tidiazb/Proyecto_03_Batalla_Naval/Planteamiento_Diseno/datapath/N2_core.png

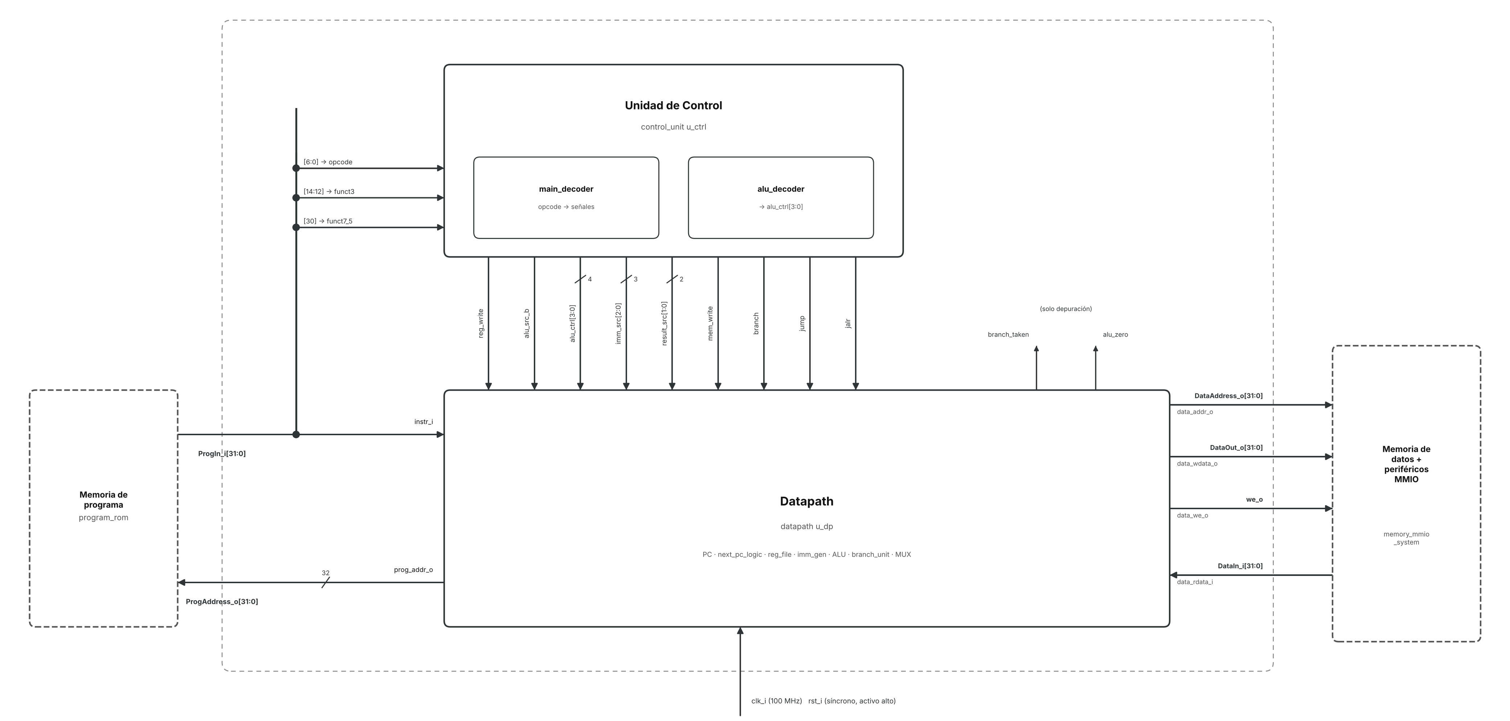
Planteamiento_Diseno/datapath/N2_core.png
