tidiazb/Proyecto_03_Batalla_Naval/Nucleo_VGA/modulos_nucleo_vga/font_rom.sv

`timescale 1ns / 1ps

// ============================================================
// Módulo: font_rom
// Descripción:
//   ROM combinacional con una fuente de 5x7 píxeles para los 64
//   caracteres ASCII imprimibles de 0x20 (espacio) a 0x5F ('_'),
//   que incluye mayúsculas, dígitos y signos de puntuación.
//
//   char_idx_i es el código ASCII menos 0x20 y row_i la fila del
//   carácter (0 = arriba, 6 = abajo). bits_o entrega los 5 píxeles
//   de esa fila; el bit 4 es el píxel de la izquierda. La fila 7
//   y cualquier combinación no listada devuelven 0.
//
//   Se sintetiza como lógica (LUTs); no consume BRAM.
//   Archivo generado a partir de la tabla de la fuente.
// ============================================================

module font_rom (
    input  logic [5:0] char_idx_i,
    input  logic [2:0] row_i,
    output logic [4:0] bits_o
);

    always_comb begin
        bits_o = 5'b00000;
        case ({char_idx_i, row_i})
            {6'd1, 3'd0}: bits_o = 5'b00100; // '!'
            {6'd1, 3'd1}: bits_o = 5'b00100; // '!'
            {6'd1, 3'd2}: bits_o = 5'b00100; // '!'
            {6'd1, 3'd3}: bits_o = 5'b00100; // '!'
            {6'd1, 3'd4}: bits_o = 5'b00100; // '!'
            {6'd1, 3'd6}: bits_o = 5'b00100; // '!'
            {6'd2, 3'd0}: bits_o = 5'b01010; // '"'
            {6'd2, 3'd1}: bits_o = 5'b01010; // '"'
            {6'd3, 3'd0}: bits_o = 5'b01010; // '#'
            {6'd3, 3'd1}: bits_o = 5'b01010; // '#'
            {6'd3, 3'd2}: bits_o = 5'b11111; // '#'
            {6'd3, 3'd3}: bits_o = 5'b01010; // '#'
            {6'd3, 3'd4}: bits_o = 5'b11111; // '#'
            {6'd3, 3'd5}: bits_o = 5'b01010; // '#'
            {6'd3, 3'd6}: bits_o = 5'b01010; // '#'
            {6'd4, 3'd0}: bits_o = 5'b00100; // '$'
            {6'd4, 3'd1}: bits_o = 5'b01111; // '$'
            {6'd4, 3'd2}: bits_o = 5'b10100; // '$'
            {6'd4, 3'd3}: bits_o = 5'b01110; // '$'
            {6'd4, 3'd4}: bits_o = 5'b00101; // '$'
            {6'd4, 3'd5}: bits_o = 5'b11110; // '$'
            {6'd4, 3'd6}: bits_o = 5'b00100; // '$'
            {6'd5, 3'd0}: bits_o = 5'b11000; // '%'
            {6'd5, 3'd1}: bits_o = 5'b11001; // '%'
            {6'd5, 3'd2}: bits_o = 5'b00010; // '%'
            {6'd5, 3'd3}: bits_o = 5'b00100; // '%'
            {6'd5, 3'd4}: bits_o = 5'b01000; // '%'
            {6'd5, 3'd5}: bits_o = 5'b10011; // '%'
            {6'd5, 3'd6}: bits_o = 5'b00011; // '%'
            {6'd6, 3'd0}: bits_o = 5'b01100; // '&'
            {6'd6, 3'd1}: bits_o = 5'b10010; // '&'
            {6'd6, 3'd2}: bits_o = 5'b10100; // '&'
            {6'd6, 3'd3}: bits_o = 5'b01000; // '&'
            {6'd6, 3'd4}: bits_o = 5'b10101; // '&'
            {6'd6, 3'd5}: bits_o = 5'b10010; // '&'
            {6'd6, 3'd6}: bits_o = 5'b01101; // '&'
            {6'd7, 3'd0}: bits_o = 5'b00100; // '''
            {6'd7, 3'd1}: bits_o = 5'b00100; // '''
            {6'd8, 3'd0}: bits_o = 5'b00010; // '('
            {6'd8, 3'd1}: bits_o = 5'b00100; // '('
            {6'd8, 3'd2}: bits_o = 5'b01000; // '('
            {6'd8, 3'd3}: bits_o = 5'b01000; // '('
            {6'd8, 3'd4}: bits_o = 5'b01000; // '('
            {6'd8, 3'd5}: bits_o = 5'b00100; // '('
            {6'd8, 3'd6}: bits_o = 5'b00010; // '('
            {6'd9, 3'd0}: bits_o = 5'b01000; // ')'
            {6'd9, 3'd1}: bits_o = 5'b00100; // ')'
            {6'd9, 3'd2}: bits_o = 5'b00010; // ')'
            {6'd9, 3'd3}: bits_o = 5'b00010; // ')'
            {6'd9, 3'd4}: bits_o = 5'b00010; // ')'
            {6'd9, 3'd5}: bits_o = 5'b00100; // ')'
            {6'd9, 3'd6}: bits_o = 5'b01000; // ')'
            {6'd10, 3'd1}: bits_o = 5'b00100; // '*'
            {6'd10, 3'd2}: bits_o = 5'b10101; // '*'
            {6'd10, 3'd3}: bits_o = 5'b01110; // '*'
            {6'd10, 3'd4}: bits_o = 5'b10101; // '*'
            {6'd10, 3'd5}: bits_o = 5'b00100; // '*'
            {6'd11, 3'd1}: bits_o = 5'b00100; // '+'
            {6'd11, 3'd2}: bits_o = 5'b00100; // '+'
            {6'd11, 3'd3}: bits_o = 5'b11111; // '+'
            {6'd11, 3'd4}: bits_o = 5'b00100; // '+'
            {6'd11, 3'd5}: bits_o = 5'b00100; // '+'
            {6'd12, 3'd4}: bits_o = 5'b00110; // ','
            {6'd12, 3'd5}: bits_o = 5'b00100; // ','
            {6'd12, 3'd6}: bits_o = 5'b01000; // ','
            {6'd13, 3'd3}: bits_o = 5'b11111; // '-'
            {6'd14, 3'd5}: bits_o = 5'b01100; // '.'
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
            {6'd59, 3'd5}: bits_o = 5'b01000; // '['
            {6'd59, 3'd6}: bits_o = 5'b01110; // '['
            {6'd60, 3'd0}: bits_o = 5'b10000; // 'backslash'
            {6'd60, 3'd1}: bits_o = 5'b10000; // 'backslash'
            {6'd60, 3'd2}: bits_o = 5'b01000; // 'backslash'
            {6'd60, 3'd3}: bits_o = 5'b00100; // 'backslash'
            {6'd60, 3'd4}: bits_o = 5'b00010; // 'backslash'
            {6'd60, 3'd5}: bits_o = 5'b00001; // 'backslash'
            {6'd60, 3'd6}: bits_o = 5'b00001; // 'backslash'
            {6'd61, 3'd0}: bits_o = 5'b01110; // ']'
            {6'd61, 3'd1}: bits_o = 5'b00010; // ']'
            {6'd61, 3'd2}: bits_o = 5'b00010; // ']'
            {6'd61, 3'd3}: bits_o = 5'b00010; // ']'
            {6'd61, 3'd4}: bits_o = 5'b00010; // ']'
            {6'd61, 3'd5}: bits_o = 5'b00010; // ']'
            {6'd61, 3'd6}: bits_o = 5'b01110; // ']'
            {6'd62, 3'd0}: bits_o = 5'b00100; // '^'
            {6'd62, 3'd1}: bits_o = 5'b01010; // '^'
            {6'd62, 3'd2}: bits_o = 5'b10001; // '^'
            {6'd63, 3'd6}: bits_o = 5'b11111; // '_'
            default: bits_o = 5'b00000;
        endcase
    end

endmodule
