tidiazb/Proyecto_03_Batalla_Naval/UART/rtl/baud_rate_generator.sv

`timescale 1ns / 1ps

module baud_rate_generator
    #(              // 9600 baud
        parameter   N = 10,     // number of counter bits
                    M = 651     // counter limit value
    )
    (
        input clk_100MHz,       // basys 3 clock
        input reset,            // reset
        output tick             // sample tick
    );
    
    // Counter Register
    logic [N-1:0] counter;        // counter value
    logic [N-1:0] next;          // next counter value
    
    // Register Logic
    always_ff @(posedge clk_100MHz, posedge reset)
        if(reset)
            counter <= 0;
        else
            counter <= next;
            
    // Next Counter Value Logic
    assign next = (counter == (M-1)) ? 0 : counter + 1;
    
    // Output Logic
    assign tick = (counter == (M-1)) ? 1'b1 : 1'b0;
       
endmodule
