tidiazb/Proyecto_03_Batalla_Naval/(commit log)

2026-09-19 Add initial README content for UART
2026-09-25 Unidad de salto compara para tomar decision y deja ALU libre
2026-09-25 Generador de immediatos
2026-09-25 Cambios en modulos, error de sintesis
    [alu.sv, branch_unit.sv, imm_gen.sv, mux_2_1.sv, mux_4_1.sv, next_pc_logic.sv, pc_reg.sv, reg_file.sv]
2026-09-25 Definicion de entradas y paquete de conexion para el control path
2026-09-25 Instancia de regisytros
2026-09-25 Ajuste de espacios e indentacion para mejor visualizacon del codigo
2026-09-25 Descripcion de que contiene y como entran las señales
2026-09-25 Sincronizacion con la base de datos
2026-09-25 Paquete que enlaza contro y data path
2026-09-25 Anchos de datos
2026-09-25 Mejora de escritura y seccionado para mejor comprension
2026-09-25 Agrega testbench de modulos primoridiales
2026-09-25 Escritura en el readme del branch data path
2026-09-25 Definicion de submodulos usados
2026-09-25 Inetrgacion en el modulo principal
2026-09-25 Mejoras de escritura en espacios e identacion
2026-09-25 Enhance README with control unit documentation
    Added detailed documentation for the RISC-V RV32I control unit, including signal descriptions, control flow, and validation results.
2026-09-26 Commit de Issue #4
    Memorias RAM, ROM, MMIO
    [data_ram.sv, memory_mmio_system.sv, mmio_interconnect.sv, program_rom.sv, tb_data_ram.sv, tb_memory_mmio_system.sv, tb_mmio_interconnect.sv, tb_program_rom.sv]
2026-09-26 Agrega tb_datapath, archivos comunes de simulación y scripts; corrige comentarios
    [adder.sv, alu.sv, mux_2_1.sv, mux_4_1.sv, ref_control.sv, riscv_pkg.sv, rv32i_enc_pkg.sv, tb_datapath.sv]
2026-09-26 Entradas de periferico para jugador 1
2026-09-26 Comunicacion UART
2026-09-26 Captura de Tb modulos DataPath
2026-09-26 Agregar las capturas de los TestBench al Readme
2026-09-26 Revise README with peripheral details and tests
    Updated README to include detailed descriptions of the local output peripherals implemented for the Batalla Naval system, including the 7-segment display, status LED, and buzzer. Added sections for file structure, tests, and integration results.
2026-09-28 Actualizar formato de readme, agrega la separacion entre diseño y tecnico
2026-09-29 Fix typos and clarify FPGA execution instructions
    Corrige errores tipográficos y mejora la claridad de las instrucciones para ejecutar la aplicación con la FPGA.
2026-09-29 Añadir sección de prueba física del generador VGA
    Se agregó una sección sobre la prueba física del generador VGA, incluyendo el objetivo, procedimiento, resultados y verificación del funcionamiento en un monitor.
2026-09-30 Commit de integracion del programa
2026-10-03 Add CPU clock enable logic and modify UART module
2026-10-03 Agrega el enable del clokc
    Problemas de tiempo de propagacion se resulven al bajar la frecuencia de operacion del procesador
    [datapath.sv]
2026-10-03 Agregar señal de enable divisor de frecuencia
2026-10-03 Agrega el enable del reloj
    Soluciona problemas de propagacion en el tiempo
    [reg_file.sv]
2026-10-03 Agregar señal de enable divisor de frecuencia
    Soluciona error de slack
    [riscv_core.sv]
2026-10-03 Agrega el mulitpath detalle
    Agrega que el procesador funcionará cada 3 ciclos del reloj principal, solucion implementada para el slack error, fuerza que se mida en la implementacion a 3 ciclos de reloj por instruccion
    [batalla_naval_basys3.xdc]
2026-10-04 Implement frame counter and cursor blink functionality
    Added frame counter and blink signal for cursor visibility.
2026-10-04 Revise README with verification and integration details
    Updated README with detailed verification results for various peripherals, including MMIO, UART, and player input systems. Added sections on integration testing and conclusions drawn from the project.
2026-10-05 Ultima versión de la interfaz gráfica del Jugador 2
2026-10-07 Readme Con Seccion Adicional
    Agregue UART MMIO PYTHON y ENTRADAS DE J1
2026-10-08 Updated Informe Tecnico con cobertura de los issues 4, 7, 8, 9
2026-10-08 Insertar Estados de UART RX y TX
